jenniferhellar/CHARIoT/README.md

# CHARIoT: A Wireless, Self-Powered Sensing Node Architecture
