jenniferhellar/CHARIoT/Meeting Notes-Agendas/Fall 2018/10_12 Team Meeting.docx

Looking at the Gantt Chart

To Do:

- Comms unit test code, get power measurements
- Order sensor
- Work on measuring energy harvesting indoors/outdoors, battery charge
- Data storage needs:

Start writing unit test code

Next weekend: get together to put together the first prototype, run the test code

Test and make sure we have all the things we need to build it
