jenniferhellar/CHARIoT/Meeting Notes-Agendas/Spring 2019/4_1 Team Meeting Agenda.docx

Choose time for final presentation

Prototype #3 - solder/test today and tomorrow?

Range test

Code

- MSP-Comms completely done?
- Accelerometer
  - Jennifer (me) found the C driver for it, but it’s kinda complicated, so Idk yet
- Fuel gauge

Showcase demo

- What EXACTLY are we doing?
- Can we have it finished by Sunday i.e. cram this week and weekend?
