jenniferhellar/CHARIoT/Documentation/System Diagram Prototype #1 Dec. 2018.pdf

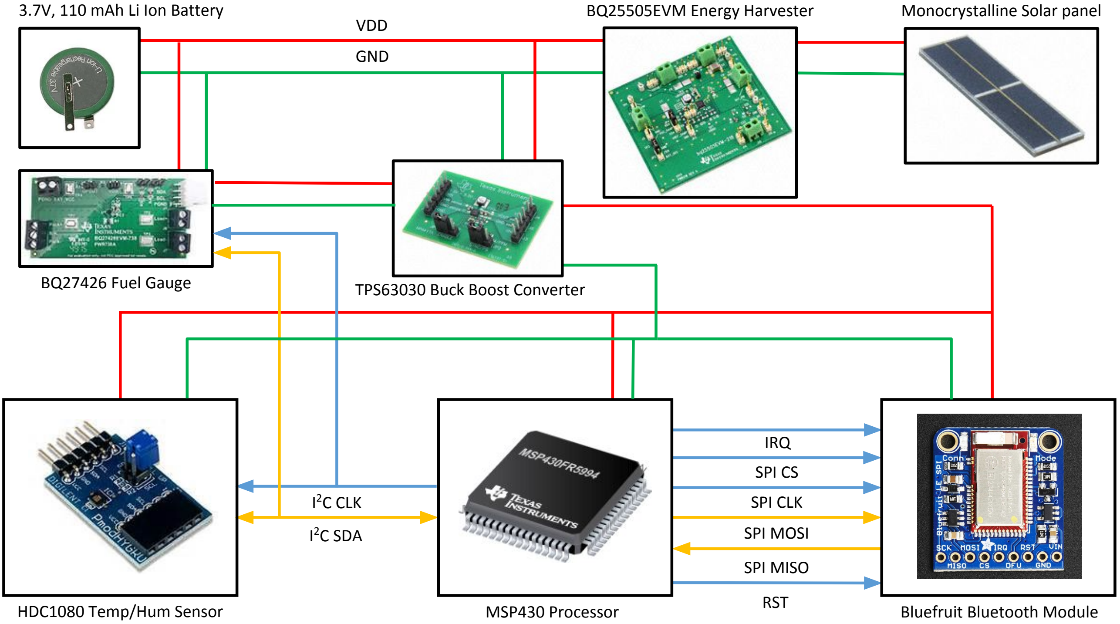
[picture p2: figure]
HDC1080 Temp/Hum Sensor; MSP430 Processor; Bluefruit Bluetooth Module; SPI MISO; SPI MOSI; SPI CLK ²C CLK; 2C SDA; VDD; GND; SPI CS; IRQ; RST

3.7V, 110 mAh Li Ion Battery | BQ25505EVM Energy Harvester | Monocrystalline Solar panel

TPS63030 Buck Boost Converter BQ27426 Fuel Gauge
