jenniferhellar/CHARIoT/Documentation/Final BOM.xlsx

Sheet: Power
Item | Designator | Min # of Units | Price/Unit | Total Price | 10000 Price/Unit | 10000 Total Price | Link
Energy Harvester | U1 | 1 | 6.236 | 6.236 | 3.915 | 3.915 | https://www.digikey.com/product-detail/en/texas-instruments/BQ25570RGRR/296-39934-1-ND/5177811
Battery | U2 | 1 | 11.09 | 11.09 | 7.033 | 7.033 | https://www.digikey.com/products/en?keywords=RJD2430C1ST1
Fuel Gauge | U3 | 1 | 2.33 | 2.33 | 1.27 | 1.27 | https://www.digikey.com/product-detail/en/texas-instruments/BQ27411DRZR-G1A/296-39935-1-ND/5177812
Solarcell | U4-U7 | 4 | $3.30 | $13.20 | 1.9536 | 7.8144 | NA
7.5MΩ | R1 | 1 | 0.12 | 0.12 | 0.02 | 0.02 | https://www.mouser.com/ProductDetail/ROHM-Semiconductor/KTR03EZPF7504
5.76MΩ | R2 | 1 | 0.04 | 0.04 | 0.004 | 0.004 | https://www.mouser.com/ProductDetail/Vishay/CRCW06035M76FKEA?qs=sGAEpiMZZMvdGkrng054t9YoKDts9whp3wjiTgYcou0%3d
374kΩ | R3 | 1 | 0.05 | 0.05 | 0.01 | 0.01 | https://www.mouser.com/ProductDetail/Yageo/RT0603FRE07374KL
6.65MΩ | R4 | 1 | 0.1 | 0.1 | 0.004 | 0.004 | https://www.mouser.com/ProductDetail/Vishay/CRCW06036M65FKEA?qs=sGAEpiMZZMvdGkrng054t9YoKDts9whp80c4NOm47Uw%3d
4.53MΩ | R5 | 1 | 0.01 | 0.01 | 0.002 | 0.002 | https://www.mouser.com/ProductDetail/Yageo/RC0603FR-074M53L
7.68MΩ | R6 | 1 | 0.04 | 0.04 | 0.002 | 0.002 | https://www.mouser.com/ProductDetail/Vishay/CRCW06037M68FKEA
4.42 MΩ | R7 | 1 | 0.01 | 0.01 | 0.002 | 0.002 | https://www.mouser.com/ProductDetail/Yageo/RC0603FR-074M42L
0.01Ω | R8 | 1 | 0.47 | 0.47 | 0.2 | 0.2 | https://www.mouser.com/ProductDetail/ROHM-Semiconductor/PMR03EZPFU10L0
DNP | R9-R10, R20 | - | - | - | - | -
0Ω | R14,R19 | - | - | - | - | -
1Ω | R15-R16 | 2 | 0.41 | 0.82 | 0.16 | 0.32 | https://www.mouser.com/ProductDetail/Yageo/SR0603FR-7T1RL
1MΩ | R17-R18 | 2 | 0.04 | 0.08 | 0.002 | 0.004 | https://www.mouser.com/ProductDetail/vishay/crcw06031m96fkea/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
22uH | L3 | 1 | 0.14 | 0.14 | 0.0632 | 0.0632 | https://www.mouser.com/ProductDetail/TDK/KLZ1608MHR220WTD25
10uH | L6 | 1 | 0.12 | 0.12 | 0.0542 | 0.0542 | https://www.mouser.com/ProductDetail/TDK/MLZ1608N100L
headers | J- | 1 | 7.95 | 7.95 | 6.36 | 6.36 | https://www.adafruit.com/product/3008
.01uF* | C1 | 1 | 0.012 | 0.012 | 0.004878 | 0.004878
0.1uF* | C2, C9 | 2 | 0.00853 | 0.01706 | 0.009756 | 0.019512
4.7uF | C3, C8 | 2 | 0.36 | 0.72 | 0.12 | 0.24 | https://www.mouser.com/ProductDetail/Murata-Electronics/GRT188C81E475KE13D
0.47uF | C4 | 1 | 0.32 | 0.32 | 0.1 | 0.1 | https://www.mouser.com/ProductDetail/KEMET/C0603C474J4RACAUTO
22uF | C5 | 1 | 0.3 | 0.3 | 0.08 | 0.08 | https://www.mouser.com/ProductDetail/Murata-Electronics/ZRB18AR61A226ME01L
100uF | C6 | 1 | 0.38 | 0.38 | 0.17 | 0.17 | https://www.mouser.com/ProductDetail/AVX/F980J107MMAAXE
1uF* | C13 | 1 | 0.0243 | 0.0243 | 0.019512 | 0.019512
 |  | Total component costs |  | 44.57936 |  | 27.711702
Final Cost Breakdown | Prototype | 10,000 unit production
Components | 44.57936 | 27.711702
Base PCB | 7.447 | 0.863465
Labor | 48.37 | 2.243188
Total | 100.39636 | 30.818355

Sheet: Comms
Item | designator | Min # of Units | Price/Unit | Total Price | 10000 Price/Unit | 10000Total Price | Link
32KHz crystal oscillator* | 32K | 1 | 0.46 | 0.46 | 0.2134147671 | 0.2134147671
48MHz crystal oscillator* | 48M | 1 | 0.86 | 0.86 | 0.48 | 0.48
12pF | C2,C5-C6,C101 | 4 | 0.0286 | 0.1144 | 0.01663 | 0.06652 | https://www.digikey.com/product-detail/en/CC0603JRNPO9BN120/311-1059-1-ND/302969?so=58739282
1.8pF | C102 | 1 | 0.061 | 0.061 | 0.0153 | 0.0153 | https://www.digikey.com/product-detail/en/yageo/CC0603CRNPO9BN1R8/311-3852-1-ND/8024941
22uF | C10,C14 | 2 | 0.3 | 0.6 | 0.08 | 0.16 | https://www.mouser.com/ProductDetail/Murata-Electronics/ZRB18AR61A226ME01L
0.1uF* | C8-C9,C11-C13,C15-C16 | 7 | 0.00853 | 0.05971 | 0.004878 | 0.034146
1pF | C1,C3,C7 | 3 | 0.061 | 0.183 | 0.0153 | 0.0459 | https://www.digikey.com/product-detail/en/yageo/CC0603CRNPO9BN1R8/311-3852-1-ND/8024941
1uF* | C4,CIN | 2 | 0.0243 | 0.0486 | 0.019512 | 0.039024
1nF* | CT | 1 | 0.0109 | 0.0109 | 0.006098 | 0.006098
schottky diode* | D1 | 1 | 0.1097 | 0.1097 | 0.071951 | 0.071951
ferrite beads* | Filter | 1 | 0.16 | 0.16 | 0.0650367814 | 0.0650367814 | https://www.digikey.com/product-detail/en/murata-electronics-north-america/BLM18HE152SN1D/490-5216-1-ND/1948392
headers | J1-J6 | 4 | 0.59 | 2.36 |  | 0
2.4nH | L1,L4 | 2 | 0.21 | 0.42 | 0.09782 | 0.19564 | https://www.digikey.com/product-detail/en/murata-electronics-north-america/LQW18AN2N4C80D/490-14721-1-ND/6606327
2nH | L2-L3 | 2 | 0.244 | 0.488 | 0.1097 | 0.2194 | https://www.digikey.com/product-detail/en/johanson-technology-inc/L-14W2N0CV4E/712-1618-1-ND/6612954
8.6uH | L6 | 1 | 0.471 | 0.471 | 0.22874 | 0.22874 | https://www.digikey.com/product-detail/en/abracon-llc/AISC-0603F-8R2J-T/535-12536-1-ND/4864679
green led* | LED1 | 1 | 0.219 | 0.219 | 0.060976 | 0.060976
100kΩ* | R1 | 1 | 0.0097 | 0.0097 | 0.003659 | 0.003659
100Ω* | R4 | 1 | 0.0097 | 0.0097 | 0.003659 | 0.003659
500 | REXT | 1 | 2.812 | 2.812 | 1.28 | 1.28 | https://www.digikey.com/product-detail/en/vishay-dale/TNPU0603500RAZEN00/541-3301-1-ND/6615958
DNP | R_BP | 0 |  | 0 |  | 0
47kΩ | R_PD | 1 | 0.02 | 0.02 | 0.00395 | 0.00395 | https://www.digikey.com/product-detail/en/yageo/RC0603JR-0747KL/311-47KGRCT-ND/729741
DNP | R_SMA | 0 |  | 0 |  | 0
DNP | SMA | 0 |  | 0 |  | 0
load switch | TPS22918 | 1 | 0.38 | 0.38 | 0.20365816 | 0.20365816 | http://www.ti.com/product/TPS22918/technicaldocuments?HQS=TI-null-null-octopart-df-pf-null-wwe
mcu | U1 | 1 | 5.29 | 5.29 | 3 | 3 | http://www.ti.com/product/CC2652R
 |  | Total Components Cost |  | 15.14671 |  | 6.397072708
Final Cost Breakdown | Prototype | 10,000 unit production
Components | 15.14671 | 6.397072708
Base PCB | 8.954 | 1.07929
Labor | 61.178 | 2.273723
Total | 85.27871 | 9.750085708

Sheet: Processor
Item | Designator | Min # of Units | Price/Unit | Total Price | 10000 Price/Unit | 10000Total Price | Link
Accelerometer | ACCEL | 1 | $1.61 | $1.61 | 0.63 | 0.63 | https://www.mouser.com/ProductDetail/Bosch-Sensortec/BMA253?qs=z6PAvqrnkvQsf%2FKkNyclQA%3D%3D
0.1uF* | C0-C1,C3,C5,C7,C9,C11,C15 | 8 | 0.00853 | 0.06824 | 0.004878 | 0.039024
1uF* | C2,C4,C6,C8,C10,C12 | 6 | 0.0243 | 0.1458 | 0.01951216667 | 0.117073
1nF* | C13 | 1 | 0.0109 | 0.0109 | 0.006098 | 0.006098
22uF | C14 | 1 | 0.3 | 0.3 | 0.08 | 0.08 | https://www.mouser.com/ProductDetail/Murata-Electronics/ZRB18AR61A226ME01L
Schottky diode* | D1 | 1 | 0.1097 | 0.1097 | 0.071951 | 0.071951
headers | J1-5 | 1 | - | - | - | -
headers | JTAG | 1 | - | - | - | -
green led* | LED1 | 1 | 0.219 | 0.219 | 0.060976 | 0.060976
red led* | LED2 | 1 | 0.219 | 0.219 | 0.060976 | 0.060976
msp430fr59941pnr | MSP430 | 1 | $6.91 | $6.91 | 4.18 | 4.18 | https://www.mouser.com/ProductDetail/Texas-Instruments/MSP430FR5994IPNR
2kΩ* | R1-R2 | 2 | 0.00975 | 0.0195 | 0.0036585 | 0.007317
4.7kΩ* | R3 | 1 | 0.00975 | 0.00975 | 0.003659 | 0.003659
100Ω | R4-R5 | 2 | 0.00975 | 0.0195 | 0.0036585 | 0.007317
2kΩ* | R8-R9 | 2 | 0.00975 | 0.0195 | 0.0036585 | 0.007317
temperature & humidity sensor | TEMP_SENSOR | 1 | $2.51 | $2.51 | 1.27 | 1.27 | https://www.mouser.com/ProductDetail/Texas-Instruments/HDC1080DMBR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
 |  | Total component costs |  | $12.17 |  | 6.541708
Final Cost Breakdown | Prototype | 10,000 unit production
Components | $12.17 | 6.541708
Base PCB | 7.447 | 0.863465
Labor | 51.252 | 2.253366
Total | $70.87 | 9.658539

Sheet: Part Numbers
Part Name | Part Designator | Part Number
Energy harvesting | U1 | BQ25570RGRR
Battery | U1 | RJD2430C1ST1
Fuel gauge | U3 | BQ27411DRZR-G1A
Solarcell | U4-U7 | KXOB22-04X3F
Processor | MSP430 | MSP430FR9941PNR
Temperature & Humidity Sensor | TEMP_SENSOR | HDC1080DMBR
Accelerometer | ACCEL | BMA253
32KHz crystal oscillator | 32K | FC-135 32.7680KA-A3
48MHz crystal oscillator | 48M | NX2016SA-48M-EXS00A-CS05517
schottky diode | D1 | MF-DIO-SOD123-BAT42
ferrite beads | Filter | BLM18HE152SN1D
load switch | TPS22918 | TPS22918
MCU | U1 | CC2652R
