jenniferhellar/CHARIoT/(list of files, cad)

Other CAD files:
Code/TICommsWorkspace/ble5_project_zero_cc26x2r1lp_app/TOOLS/src/sysbios/m3_Hwi_asm_switch.obj
Code/TICommsWorkspace/ble5_simple_peripheral_cc26x2r1lp_app/TOOLS/src/sysbios/m3_IntrinsicsSupport_asm.obj
Code/TICommsWorkspaceRevE/simple_central_app_CC26X2R1_LAUNCHXL_tirtos_ccs/src/sysbios/m3_IntrinsicsSupport_asm.obj
Code/TICommsWorkspace/ble5_project_zero_cc26x2r1lp_app/TOOLS/src/sysbios/m3_Hwi_asm.obj
Code/TICommsWorkspace/ble5_simple_central_cc26x2r1lp_app/TOOLS/src/sysbios/m3_Hwi_asm.obj
Code/TICommsWorkspaceRevE/simple_central_app_CC26X2R1_LAUNCHXL_tirtos_ccs/src/sysbios/m3_Hwi_asm_switch.obj
Code/TICommsWorkspace/ble5_project_zero_cc26x2r1lp_app/TOOLS/src/sysbios/m3_TaskSupport_asm.obj
Code/TICommsWorkspace/ble5_simple_central_cc26x2r1lp_app/TOOLS/src/sysbios/m3_IntrinsicsSupport_asm.obj
Code/TICommsWorkspace/ble5_simple_peripheral_cc26x2r1lp_app/TOOLS/src/sysbios/m3_Hwi_asm_switch.obj
Code/TICommsWorkspace/ble5_simple_central_cc26x2r1lp_app/TOOLS/src/sysbios/m3_TaskSupport_asm.obj
Code/TICommsWorkspace/ble5_simple_peripheral_cc26x2r1lp_app/TOOLS/src/sysbios/m3_TaskSupport_asm.obj
Code/TICommsWorkspaceRevE/simple_central_app_CC26X2R1_LAUNCHXL_tirtos_ccs/src/sysbios/m3_Hwi_asm.obj
Code/TICommsWorkspace/ble5_project_zero_cc26x2r1lp_app/TOOLS/src/sysbios/m3_IntrinsicsSupport_asm.obj
Code/TICommsWorkspace/ble5_simple_central_cc26x2r1lp_app/TOOLS/src/sysbios/m3_Hwi_asm_switch.obj
Code/TICommsWorkspace/ble5_simple_peripheral_cc26x2r1lp_app/TOOLS/src/sysbios/m3_Hwi_asm.obj
Code/TICommsWorkspaceRevE/simple_central_app_CC26X2R1_LAUNCHXL_tirtos_ccs/src/sysbios/m3_TaskSupport_asm.obj
Code/TICommsWorkspace/ble5_simple_central_cc26x2r1lp_app/TOOLS/src/sysbios/BIOS.obj
Code/TICommsWorkspace/ble5_simple_peripheral_cc26x2r1lp_app/TOOLS/src/sysbios/rom_sysbios.obj
Code/TICommsWorkspaceRevE/simple_central_app_CC26X2R1_LAUNCHXL_tirtos_ccs/src/sysbios/rom_sysbios.obj
Code/TICommsWorkspace/ble5_project_zero_cc26x2r1lp_app/TOOLS/src/sysbios/BIOS.obj
Code/TICommsWorkspace/ble5_simple_central_cc26x2r1lp_app/TOOLS/src/sysbios/rom_sysbios.obj
