jenniferhellar/CHARIoT/Boards/Prototype #2 (PCB Ver. A1)/CHARIoT_Power/chariot_power.brd

## EAGLE design Boards/Prototype #2 (PCB Ver. A1)/CHARIoT_Power/chariot_power.brd (2020-01-18)

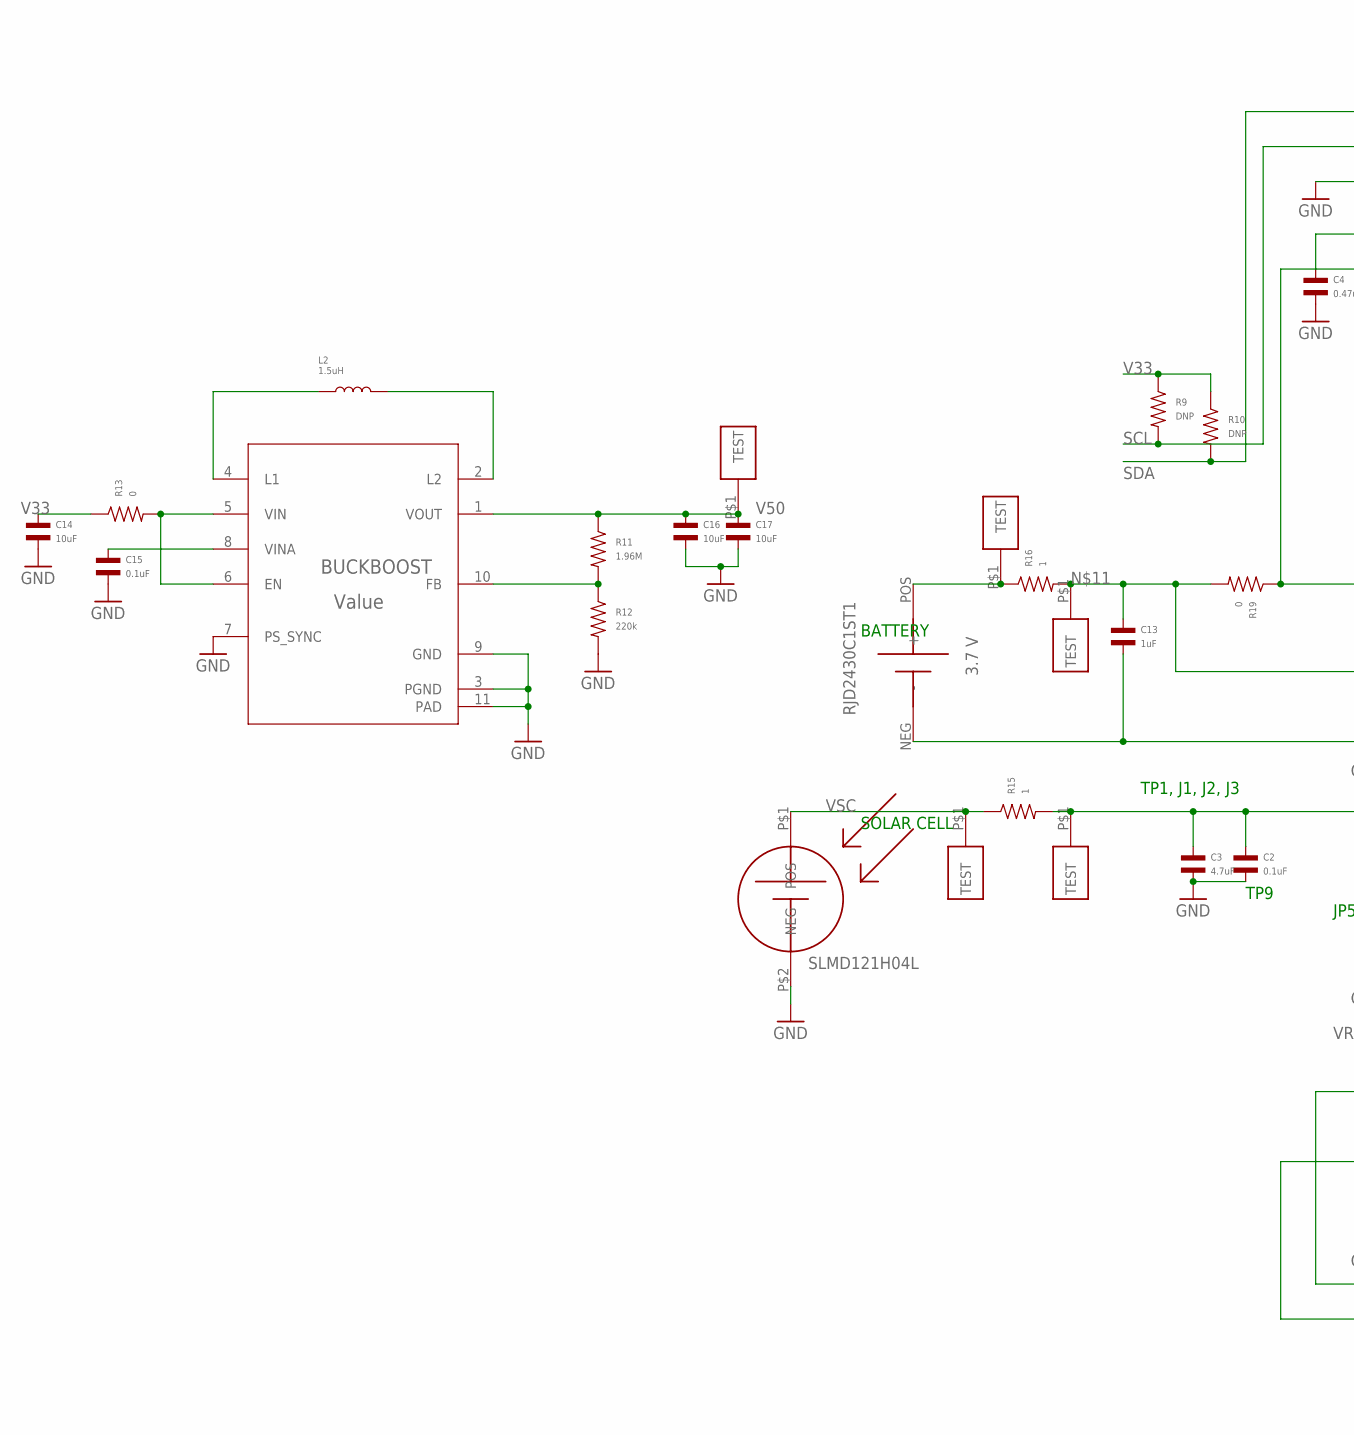
[picture p13: schematic chariot_power.sch, part in row 1, column 1]

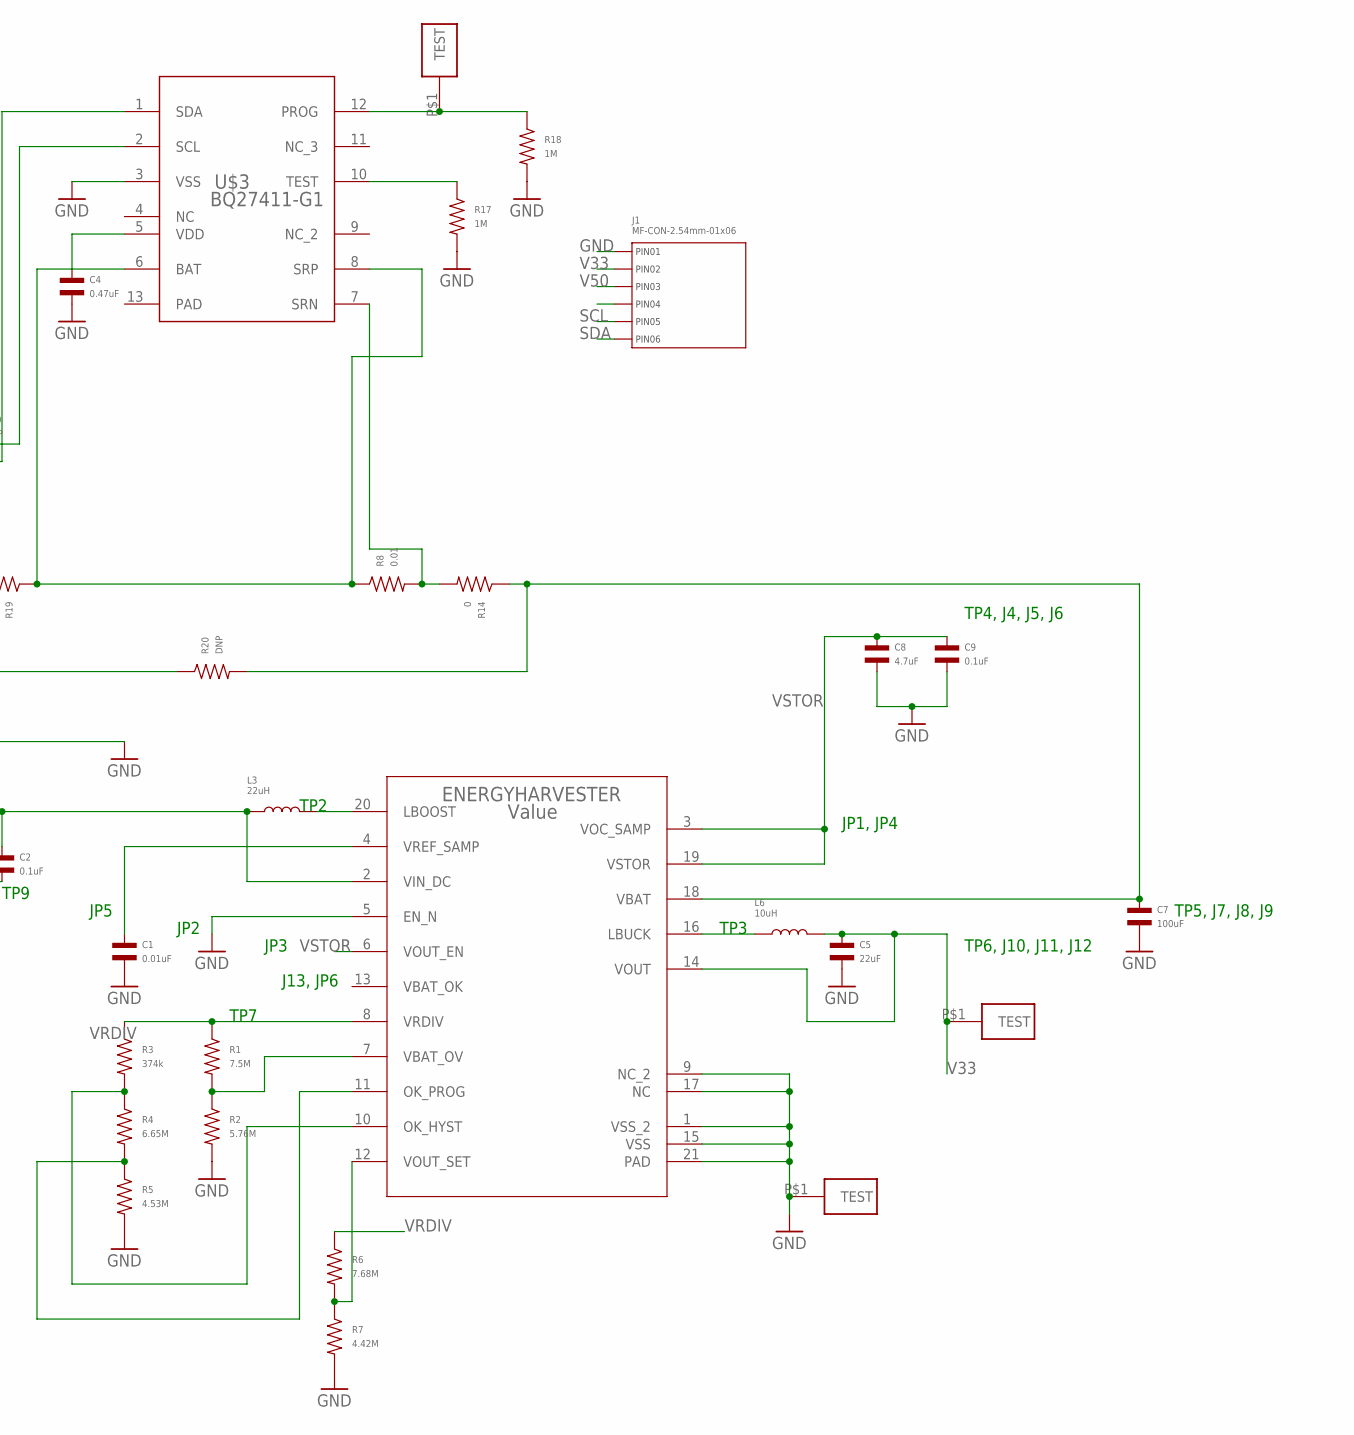
[picture p14: schematic chariot_power.sch, part in row 1, column 2]

Parts:
BUCKBOOST: Value; DSK0010A
C1: 0.01uF; C0603
C2, C9, C15: 0.1uF; C0603
C3, C8: 4.7uF; C0603
C4: 0.47uF; C0603
C5: 22uF; C0603
C7: 100uF; C0603
C13: 1uF; C0603
C14, C16, C17: 10uF; C0603
ENERGYHARVESTER: Value; RGR0020A
J1: MF-CON-2.54mm-01x06; PTH_2.54MM_01X06
L2: 1.5uH; L0603
L3: 22uH; L0603
L6: 10uH; L0603
R1: 7.5M; R0603
R2: 5.76M; R0603
R3: 374k; R0603
R4: 6.65M; R0603
R5: 4.53M; R0603
R6: 7.68M; R0603
R7: 4.42M; R0603
R8: 0.01; R0603
R9, R10, R20: DNP; R0603
R11: 1.96M; R0603
R12: 220k; R0603
R13, R14, R19: 0; R0603
R15, R16: 1; R0603
R17, R18: 1M; R0603
TP1, TP2, TP3, TP4, TP5, TP6, TP7, TP8: TESTPOINT_LOOP
U$1: SLMD121H04L
U$2: RJD2430C1ST1.; RJD2430C1ST1
U$3: BQ27411-G1; DRZ0012A

Connections:
EXT_VCC: J1.P$4 (PIN4)
GND: BUCKBOOST.3 (PGND), BUCKBOOST.7 (PS_SYNC), BUCKBOOST.9 (GND), BUCKBOOST.11 (PAD), C1.P$2, C2.P$2, C3.P$2, C4.P$2, C5.P$2, C7.P$2, C8.P$2, C9.P$2, C13.P$2, C14.P$2, C15.P$2, C16.P$2, C17.P$2, ENERGYHARVESTER.1 (VSS_2), ENERGYHARVESTER.5 (EN_N), ENERGYHARVESTER.9 (NC_2), ENERGYHARVESTER.15 (VSS), ENERGYHARVESTER.17 (NC), ENERGYHARVESTER.21 (PAD), J1.P$1 (PIN1), R2.P$2, R5.P$2, R7.P$2, R12.P$2, R17.P$2, R18.P$2, TP1.P$1, U$1.P$2 (NEG), U$2.NEG (-), U$3.3 (VSS)
unnamed: C1.P$1, ENERGYHARVESTER.4 (VREF_SAMP)
unnamed: ENERGYHARVESTER.20 (LBOOST), L3.P$2
unnamed: C7.P$1, ENERGYHARVESTER.18 (VBAT), R14.P$1, R20.P$2
unnamed: ENERGYHARVESTER.16 (LBUCK), L6.P$1
unnamed: C14.P$1, R13.P$1
unnamed: ENERGYHARVESTER.7 (VBAT_OV), R1.P$2, R2.P$1
unnamed: ENERGYHARVESTER.12 (VOUT_SET), R6.P$2, R7.P$1
unnamed: R17.P$1, U$3.10 (TEST)
unnamed: ENERGYHARVESTER.10 (OK_HYST), R3.P$2, R4.P$1
unnamed: ENERGYHARVESTER.11 (OK_PROG), R4.P$2, R5.P$1
unnamed: C13.P$1, R16.P$2, R19.P$2, R20.P$1, TP7.P$1
unnamed: BUCKBOOST.4 (L1), L2.P$1
unnamed: R8.P$2, R14.P$2, U$3.7 (SRN)
unnamed: R18.P$1, TP8.P$1, U$3.12 (PROG)
unnamed: C4.P$1, U$3.5 (VDD)
unnamed: BUCKBOOST.2 (L2), L2.P$2
unnamed: BUCKBOOST.8 (VINA), C15.P$1
unnamed: BUCKBOOST.10 (FB), R11.P$2, R12.P$1
SCL: J1.P$5 (PIN5), R9.P$2, U$3.2 (SCL)
SDA: J1.P$6 (PIN6), R10.P$2, U$3.1 (SDA)
V33: BUCKBOOST.5 (VIN), BUCKBOOST.6 (EN), C5.P$1, ENERGYHARVESTER.14 (VOUT), J1.P$2 (PIN2), L6.P$2, R9.P$1, R10.P$1, R13.P$2, TP2.P$1
V50: BUCKBOOST.1 (VOUT), C16.P$1, C17.P$1, J1.P$3 (PIN3), R11.P$1, TP3.P$1
VBAT: R16.P$1, TP5.P$1, U$2.POS (+)
VBAT2: R8.P$1, R19.P$1, U$3.6 (BAT), U$3.8 (SRP)
VIN1: C2.P$1, C3.P$1, ENERGYHARVESTER.2 (VIN_DC), L3.P$1, R15.P$2, TP6.P$1
VRDIV: ENERGYHARVESTER.8 (VRDIV), R1.P$1, R3.P$1, R6.P$1
VSC: R15.P$1, TP4.P$1, U$1.P$1 (POS)
VSTOR: C8.P$1, C9.P$1, ENERGYHARVESTER.3 (VOC_SAMP), ENERGYHARVESTER.6 (VOUT_EN), ENERGYHARVESTER.19 (VSTOR)

Notes on the sheet:
TP2
JP5
JP2
TP9
TP3
TP6, J10, J11, J12
TP1, J1, J2, J3
J13, JP6
TP5, J7, J8, J9
JP3
TP7
JP1, JP4
TP4, J4, J5, J6
SOLAR CELL
BATTERY

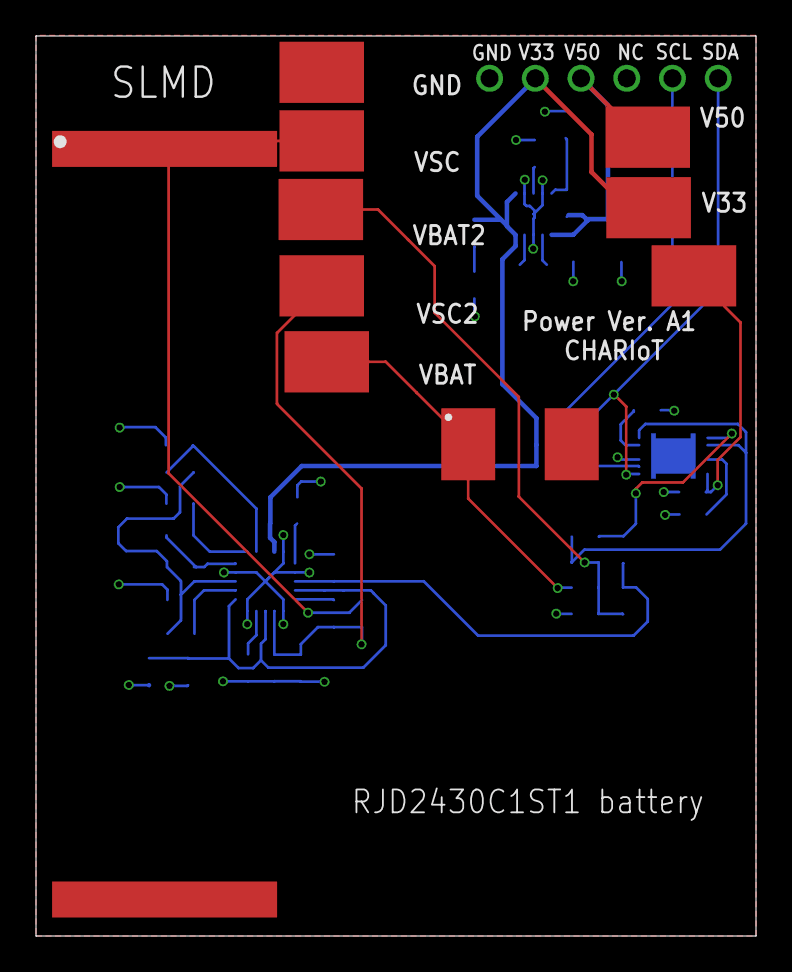
[picture p15: board chariot_power.brd from above]

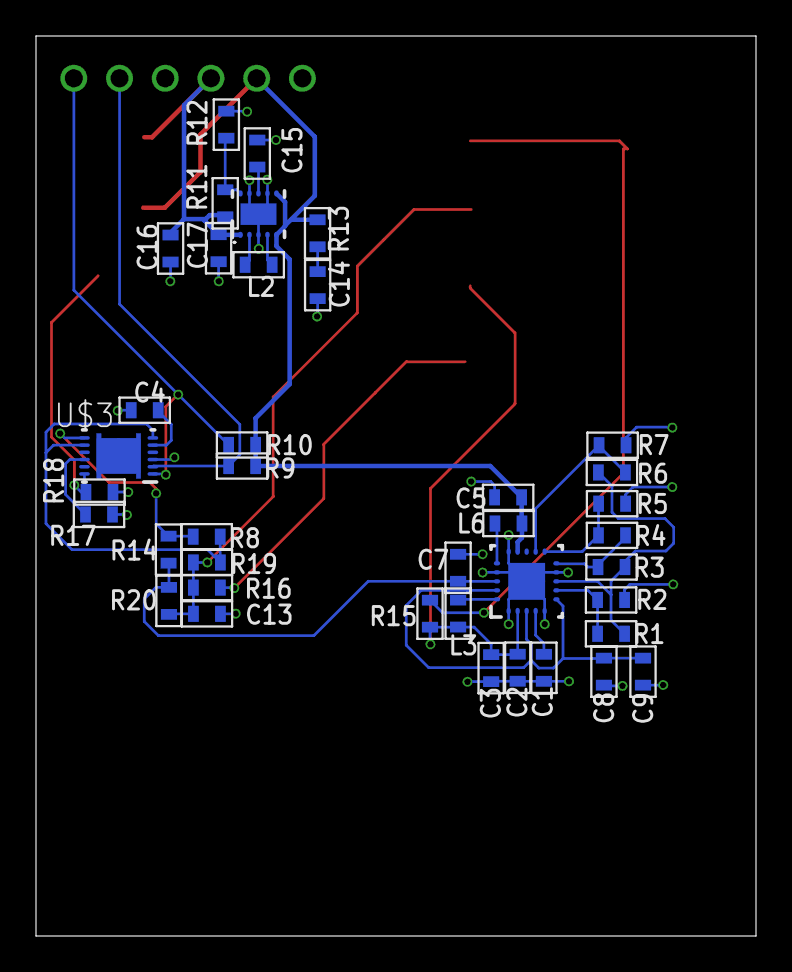
[picture p16: board chariot_power.brd from below]

Board: 2 copper layers, 40.0 x 50.0 mm, 50 parts (39 on the bottom side), 29 nets.
