jenniferhellar/CHARIoT/Boards/Prototype #2 (PCB Ver. A1)/CHARIoT_CommsA/chariot_comms_a.brd

## EAGLE design Boards/Prototype #2 (PCB Ver. A1)/CHARIoT_CommsA/chariot_comms_a.brd (2020-01-18)

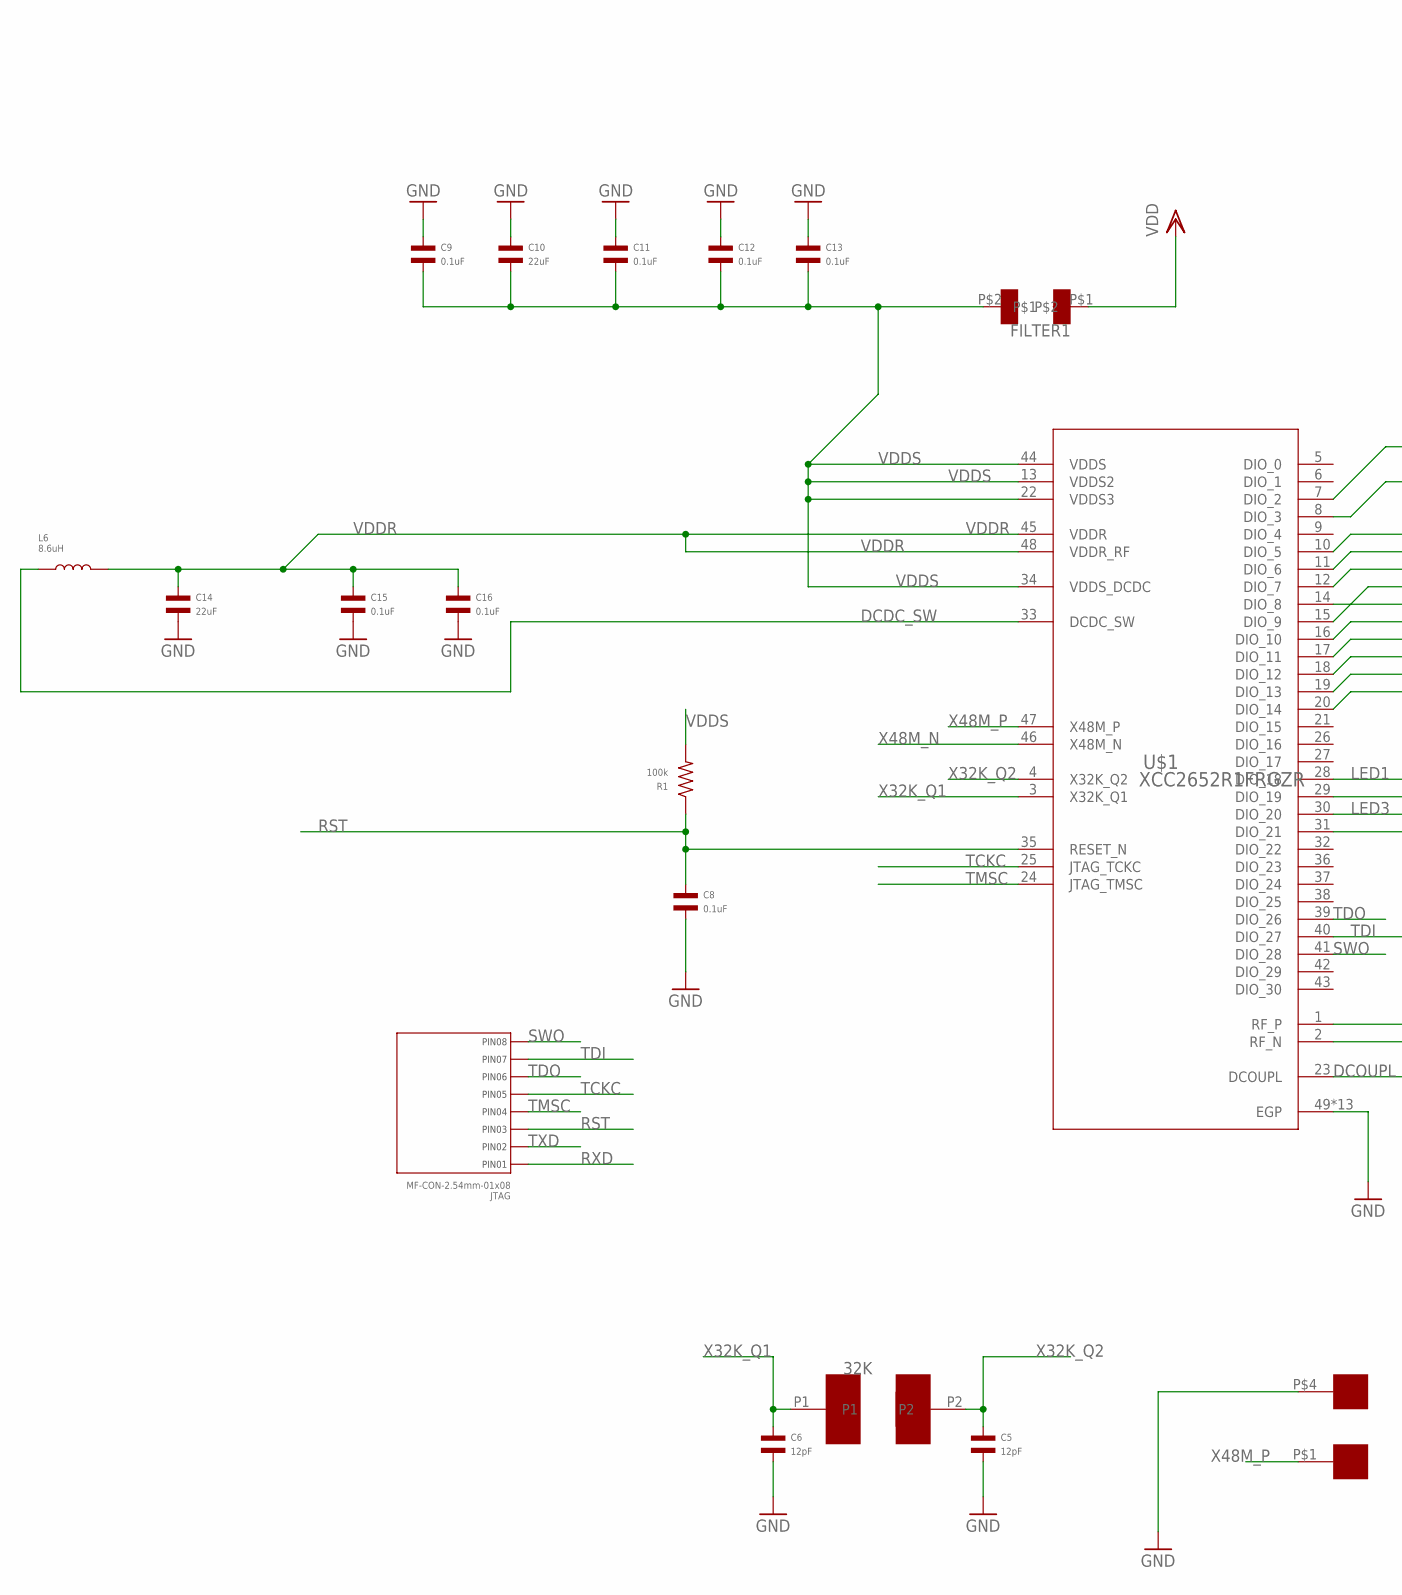
[picture p17: schematic chariot_comms_a.sch, part in row 1, column 1]

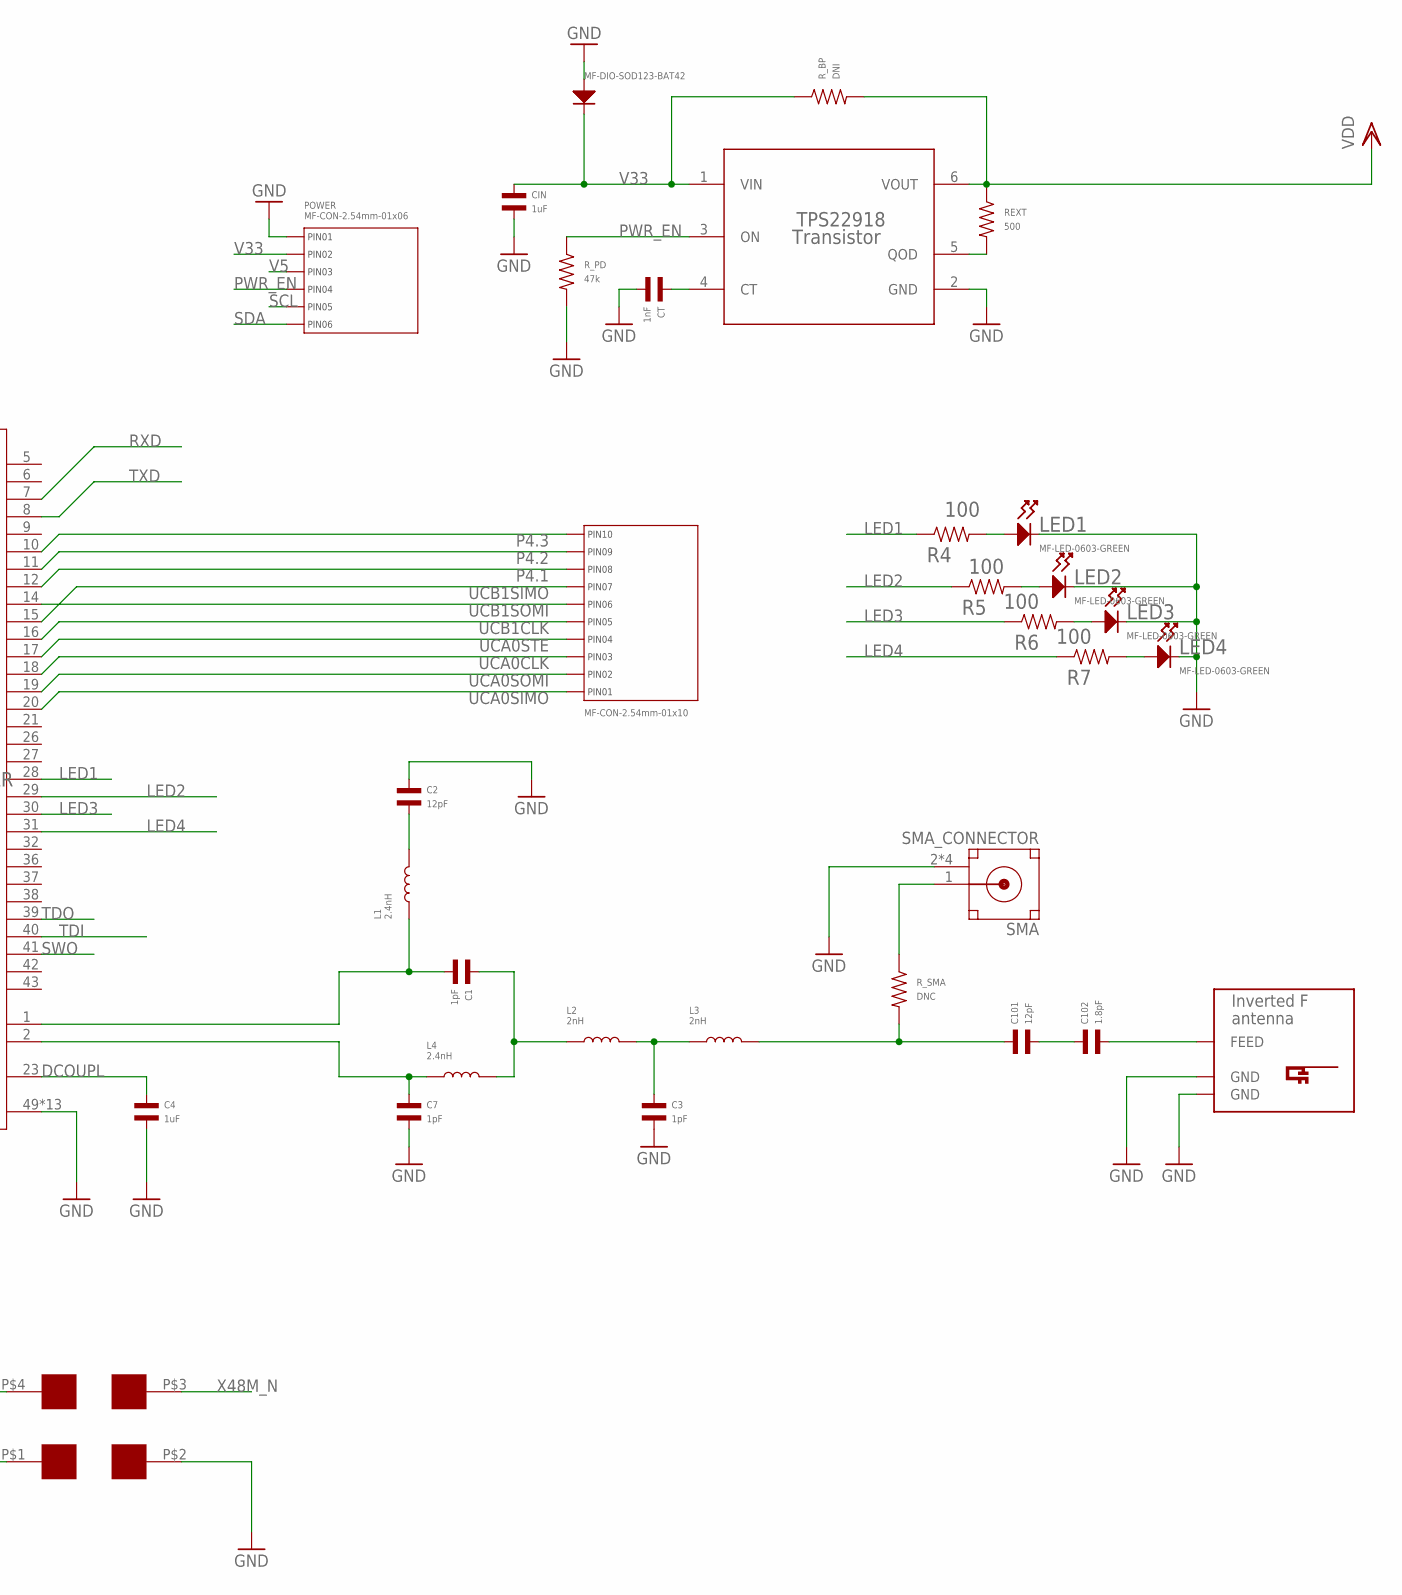
[picture p18: schematic chariot_comms_a.sch, part in row 1, column 2]

Parts:
32K: FC-135
48M: NX2016SA-48M-EXS00A-CS05517
C1, C3, C7: 1pF; C0603
C2, C5, C6, C101: 12pF; C0603
C4: 1uF; C0603
C8, C9, C11, C12, C13, C15, C16: 0.1uF; C0603
C10, C14: 22uF; C0603
C102: 1.8pF; C0603
CIN: 1uF; C0603
COMMS_J: MF-CON-2.54mm-01x10; PTH_2.54MM_01X10
CT: 1nF; C0603
D1: MF-DIO-SOD123-BAT42; SOD-123
FILTER1: BLM18HE152SN1D
JTAG: MF-CON-2.54mm-01x08; PTH_2.54MM_01X08
L1, L4: 2.4nH; L0603
L2, L3: 2nH; L0603
L6: 8.6uH; L0603
LED1, LED2, LED3, LED4: MF-LED-0603-GREEN; LED0603
POWER: MF-CON-2.54mm-01x06; PTH_2.54MM_01X06
R1: 100k; R0603
R4, R5, R6, R7: 100; R0603
REXT: 500; R0603
R_BP: DNI; R0603
R_PD: 47k; R0603
R_SMA: DNC; R0603
SMA: SMA_CONNECTOR; LPRS_SMA_CONNECTOR
TPS22918: Transistor; DBV0006A_N
U$1: XCC2652R1FRGZR; RGZ0048A
U$2: INVERTED_F_ANTENNA+5; DN007+5

Connections:
DCDC_SW: L6.P$1, U$1.33 (DCDC_SW)
DCOUPL: C4.P$1, U$1.23 (DCOUPL)
GND: 48M.P$2, 48M.P$4, C2.P$1, C3.P$2, C4.P$2, C5.P$2, C6.P$2, C7.P$2, C8.P$2, C9.P$1, C10.P$1, C11.P$1, C12.P$1, C13.P$1, C14.P$2, C15.P$2, C16.P$2, CIN.P$2, CT.P$2, D1.ANODE, LED1.CATHODE, LED2.CATHODE, LED3.CATHODE, LED4.CATHODE, POWER.P$1 (PIN1), R_PD.P$2, SMA.2 (GND), SMA.3 (GND), SMA.4 (GND), SMA.5 (GND), TPS22918.2 (GND), U$1.49 (EGP), U$1.V1 (EGP), U$1.V2 (EGP), U$1.V3 (EGP), U$1.V4 (EGP), U$1.V5 (EGP), U$1.V6 (EGP), U$1.V7 (EGP), U$1.V8 (EGP), U$1.V9 (EGP), U$1.V10 (EGP), U$1.V11 (EGP), U$1.V12 (EGP), U$2.GND, U$2.GND@1 (GND)
LED1: R4.P$1, U$1.28 (DIO_18)
LED2: R5.P$1, U$1.29 (DIO_19)
LED3: R6.P$1, U$1.30 (DIO_20)
LED4: R7.P$1, U$1.31 (DIO_21)
unnamed: C102.P$2, U$2.FEED
unnamed: LED1.ANODE, R4.P$2
unnamed: C2.P$2, L1.P$2
unnamed: C1.P$1, L2.P$1, L4.P$2
unnamed: C3.P$1, L2.P$2, L3.P$1
unnamed: C101.P$1, L3.P$2, R_SMA.P$2
unnamed: C101.P$2, C102.P$1
unnamed: LED2.ANODE, R5.P$2
unnamed: REXT.P$2, TPS22918.5 (QOD)
unnamed: CT.P$1, TPS22918.4 (CT)
unnamed: LED3.ANODE, R6.P$2
unnamed: LED4.ANODE, R7.P$2
unnamed: R_SMA.P$1, SMA.1 (SIG)
P4.1: COMMS_J.P$8 (PIN8), U$1.12 (DIO_7)
P4.2: COMMS_J.P$9 (PIN9), U$1.11 (DIO_6)
P4.3: COMMS_J.P$10 (PIN10), U$1.10 (DIO_5)
PWR_EN: POWER.P$4 (PIN4), R_PD.P$1, TPS22918.3 (ON)
RF_N: C7.P$1, L4.P$1, U$1.2 (RF_N)
RF_P: C1.P$2, L1.P$1, U$1.1 (RF_P)
RST: C8.P$1, JTAG.P$3 (PIN3), R1.P$1, U$1.35 (RESET_N)
RXD: JTAG.P$1 (PIN1), U$1.7 (DIO_2)
SCL: POWER.P$5 (PIN5)
SDA: POWER.P$6 (PIN6)
SWO: JTAG.P$8 (PIN8), U$1.41 (DIO_28)
TCKC: JTAG.P$5 (PIN5), U$1.25 (JTAG_TCKC)
TDI: JTAG.P$7 (PIN7), U$1.40 (DIO_27)
TDO: JTAG.P$6 (PIN6), U$1.39 (DIO_26)
TMSC: JTAG.P$4 (PIN4), U$1.24 (JTAG_TMSC)
TXD: JTAG.P$2 (PIN2), U$1.8 (DIO_3)
UCA0CLK: COMMS_J.P$3 (PIN3), U$1.18 (DIO_12)
UCA0SIMO: COMMS_J.P$1 (PIN1), U$1.20 (DIO_14)
UCA0SOMI: COMMS_J.P$2 (PIN2), U$1.19 (DIO_13)
UCA0STE: COMMS_J.P$4 (PIN4), U$1.17 (DIO_11)
UCB1CLK: COMMS_J.P$5 (PIN5), U$1.16 (DIO_10)
UCB1SIMO: COMMS_J.P$7 (PIN7), U$1.15 (DIO_9)
UCB1SOMI: COMMS_J.P$6 (PIN6), U$1.14 (DIO_8)
V5: POWER.P$3 (PIN3)
V33: CIN.P$1, D1.CATHODE, POWER.P$2 (PIN2), R_BP.P$1, TPS22918.1 (VIN)
VDD: FILTER1.P$1, REXT.P$1, R_BP.P$2, TPS22918.6 (VOUT)
VDDR: C14.P$1, C15.P$1, C16.P$1, L6.P$2, U$1.45 (VDDR), U$1.48 (VDDR_RF)
VDDS: C9.P$2, C10.P$2, C11.P$2, C12.P$2, C13.P$2, FILTER1.P$2, R1.P$2, U$1.13 (VDDS2), U$1.22 (VDDS3), U$1.34 (VDDS_DCDC), U$1.44 (VDDS)
X32K_Q1: 32K.P1, C6.P$1, U$1.3 (X32K_Q1)
X32K_Q2: 32K.P2, C5.P$1, U$1.4 (X32K_Q2)
X48M_N: 48M.P$3, U$1.46 (X48M_N)
X48M_P: 48M.P$1, U$1.47 (X48M_P)

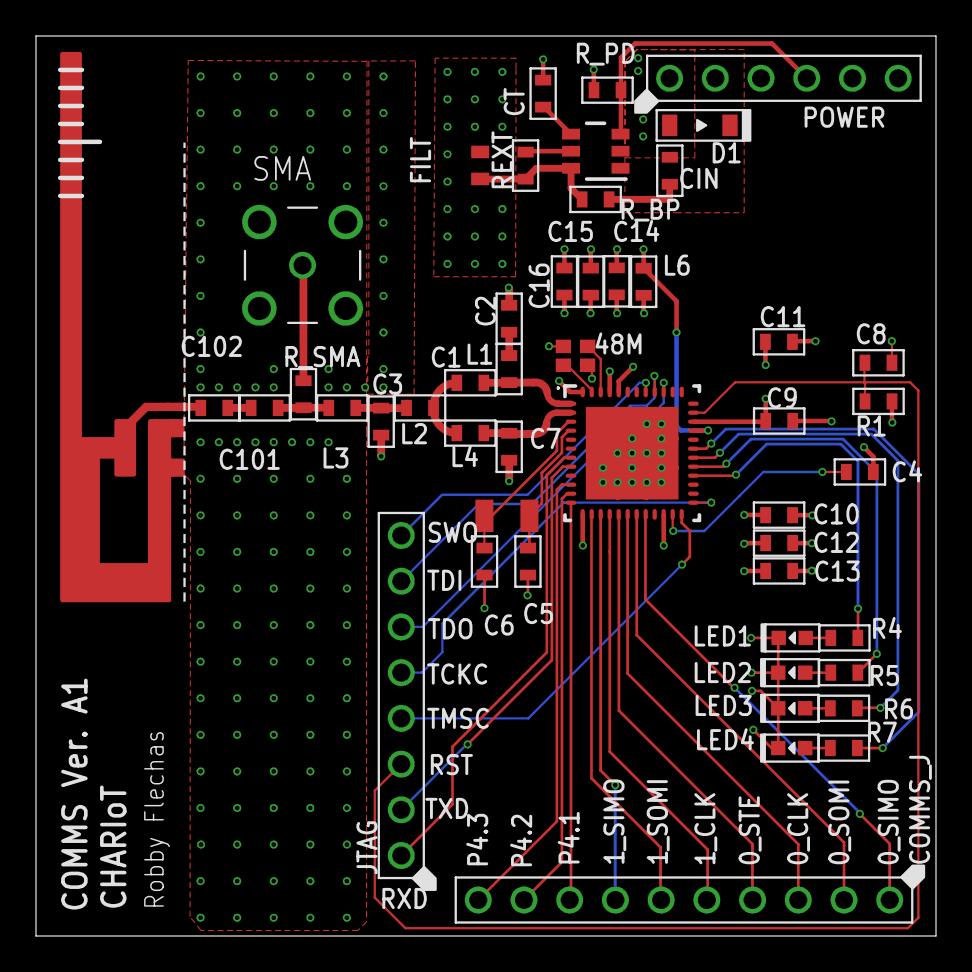
[picture p19: board chariot_comms_a.brd from above]

Board: 4 copper layers, 50.0 x 50.0 mm, 49 parts (0 on the bottom side), 49 nets.
