jenniferhellar/CHARIoT/Boards/Prototype #2 (PCB Ver. A1)/CHARIoT_Sensor/chariot_sensor.brd

## EAGLE design Boards/Prototype #2 (PCB Ver. A1)/CHARIoT_Sensor/chariot_sensor.brd (2020-01-18)

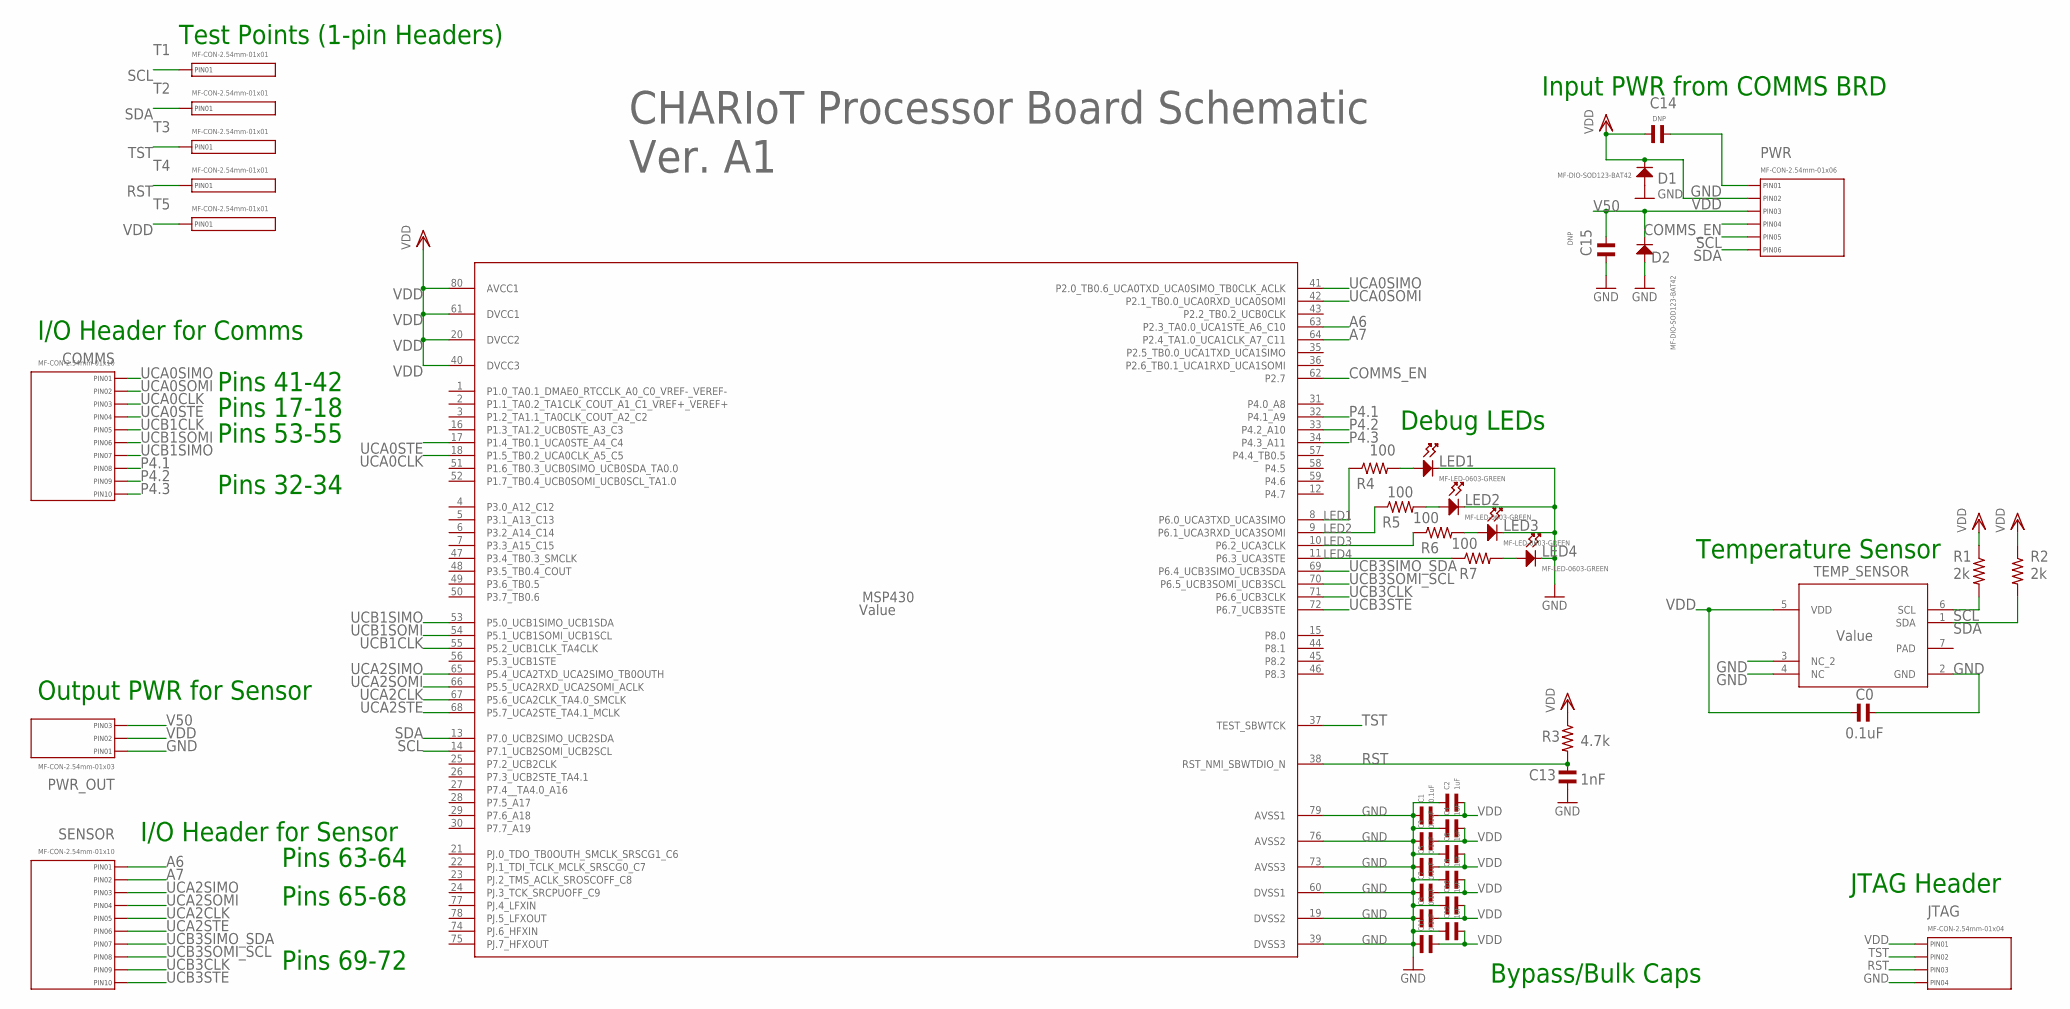
[picture p20: schematic chariot_sensor.sch]

Parts:
C0, C1, C3, C5, C7, C9, C11: 0.1uF; C0603
C2, C4, C6, C8, C10, C12: 1uF; C0603
C13: 1nF; C0603
C14, C15: DNP; C0603
COMMS: MF-CON-2.54mm-01x10; PTH_2.54MM_01X10
D1, D2: MF-DIO-SOD123-BAT42; SOD-123
JTAG: MF-CON-2.54mm-01x04; PTH_2.54MM_01X04
LED1, LED2, LED3, LED4: MF-LED-0603-GREEN; LED0603
MSP430: Value; PN0080A_N
PWR: MF-CON-2.54mm-01x06; PTH_2.54MM_01X06
PWR_OUT: MF-CON-2.54mm-01x03; PTH_2.54MM_01X03
R1, R2: 2k; R0603
R3: 4.7k; R0603
R4, R5, R6, R7: 100; R0603
SENSOR: MF-CON-2.54mm-01x10; PTH_2.54MM_01X10
T1, T2, T3, T4, T5: MF-CON-2.54mm-01x01; PTH_2.54MM_01X01
TEMP_SENSOR: Value; DMB0006A

Connections:
A6: MSP430.63 (P2.3_TA0.0_UCA1STE_A6_C10), SENSOR.P$1 (PIN1)
A7: MSP430.64 (P2.4_TA1.0_UCA1CLK_A7_C11), SENSOR.P$2 (PIN2)
COMMS_EN: MSP430.62 (P2.7), PWR.P$4 (PIN4)
GND: C0.P$2, C1.P$1, C2.P$1, C3.P$1, C4.P$1, C5.P$1, C6.P$1, C7.P$1, C8.P$1, C9.P$1, C10.P$1, C11.P$1, C12.P$1, C13.P$2, C14.P$2, C15.P$2, D1.ANODE, D2.ANODE, JTAG.P$4 (PIN4), LED1.CATHODE, LED2.CATHODE, LED3.CATHODE, LED4.CATHODE, MSP430.19 (DVSS2), MSP430.39 (DVSS3), MSP430.60 (DVSS1), MSP430.73 (AVSS3), MSP430.76 (AVSS2), MSP430.79 (AVSS1), PWR.P$1 (PIN1), PWR_OUT.P$1 (PIN1), TEMP_SENSOR.2 (GND), TEMP_SENSOR.3 (NC_2), TEMP_SENSOR.4 (NC)
LED1: MSP430.8 (P6.0_UCA3TXD_UCA3SIMO), R4.P$1
LED2: MSP430.9 (P6.1_UCA3RXD_UCA3SOMI), R5.P$1
LED3: MSP430.10 (P6.2_UCA3CLK), R6.P$1
LED4: MSP430.11 (P6.3_UCA3STE), R7.P$1
unnamed: LED1.ANODE, R4.P$2
unnamed: LED2.ANODE, R5.P$2
unnamed: LED3.ANODE, R6.P$2
unnamed: LED4.ANODE, R7.P$2
P4.1: COMMS.P$8 (PIN8), MSP430.32 (P4.1_A9)
P4.2: COMMS.P$9 (PIN9), MSP430.33 (P4.2_A10)
P4.3: COMMS.P$10 (PIN10), MSP430.34 (P4.3_A11)
PAD: TEMP_SENSOR.7 (PAD)
RST: C13.P$1, JTAG.P$3 (PIN3), MSP430.38 (RST_NMI_SBWTDIO_N), R3.P$2, T4.P$1
SCL: MSP430.14 (P7.1_UCB2SOMI_UCB2SCL), PWR.P$5 (PIN5), R1.P$2, T1.P$1, TEMP_SENSOR.6 (SCL)
SDA: MSP430.13 (P7.0_UCB2SIMO_UCB2SDA), PWR.P$6 (PIN6), R2.P$2, T2.P$1, TEMP_SENSOR.1 (SDA)
TST: JTAG.P$2 (PIN2), MSP430.37 (TEST_SBWTCK), T3.P$1
UCA0CLK: COMMS.P$3 (PIN3), MSP430.18 (P1.5_TB0.2_UCA0CLK_A5_C5)
UCA0SIMO: COMMS.P$1 (PIN1), MSP430.41 (P2.0_TB0.6_UCA0TXD_UCA0SIMO_TB0CLK_ACLK)
UCA0SOMI: COMMS.P$2 (PIN2), MSP430.42 (P2.1_TB0.0_UCA0RXD_UCA0SOMI)
UCA0STE: COMMS.P$4 (PIN4), MSP430.17 (P1.4_TB0.1_UCA0STE_A4_C4)
UCA2CLK: MSP430.67 (P5.6_UCA2CLK_TA4.0_SMCLK), SENSOR.P$5 (PIN5)
UCA2SIMO: MSP430.65 (P5.4_UCA2TXD_UCA2SIMO_TB0OUTH), SENSOR.P$3 (PIN3)
UCA2SOMI: MSP430.66 (P5.5_UCA2RXD_UCA2SOMI_ACLK), SENSOR.P$4 (PIN4)
UCA2STE: MSP430.68 (P5.7_UCA2STE_TA4.1_MCLK), SENSOR.P$6 (PIN6)
UCB1CLK: COMMS.P$5 (PIN5), MSP430.55 (P5.2_UCB1CLK_TA4CLK)
UCB1SIMO: COMMS.P$7 (PIN7), MSP430.53 (P5.0_UCB1SIMO_UCB1SDA)
UCB1SOMI: COMMS.P$6 (PIN6), MSP430.54 (P5.1_UCB1SOMI_UCB1SCL)
UCB3CLK: MSP430.71 (P6.6_UCB3CLK), SENSOR.P$9 (PIN9)
UCB3SIMO_SDA: MSP430.69 (P6.4_UCB3SIMO_UCB3SDA), SENSOR.P$7 (PIN7)
UCB3SOMI_SCL: MSP430.70 (P6.5_UCB3SOMI_UCB3SCL), SENSOR.P$8 (PIN8)
UCB3STE: MSP430.72 (P6.7_UCB3STE), SENSOR.P$10 (PIN10)
V50: C15.P$1, D2.CATHODE, PWR.P$3 (PIN3), PWR_OUT.P$3 (PIN3)
VDD: C0.P$1, C1.P$2, C2.P$2, C3.P$2, C4.P$2, C5.P$2, C6.P$2, C7.P$2, C8.P$2, C9.P$2, C10.P$2, C11.P$2, C12.P$2, C14.P$1, D1.CATHODE, JTAG.P$1 (PIN1), MSP430.20 (DVCC2), MSP430.40 (DVCC3), MSP430.61 (DVCC1), MSP430.80 (AVCC1), PWR.P$2 (PIN2), PWR_OUT.P$2 (PIN2), R1.P$1, R2.P$1, R3.P$1, T5.P$1, TEMP_SENSOR.5 (VDD)

Notes on the sheet:
Test Points (1-pin Headers)
Pins 17-18
Pins 53-55
Pins 41-42
Pins 32-34
Input PWR from COMMS BRD
Temperature Sensor
JTAG Header
Debug LEDs
Output PWR for Sensor
I/O Header for Sensor
Bypass/Bulk Caps
I/O Header for Comms
Pins 63-64
Pins 65-68
Pins 69-72
CHARIoT Processor Board Schematic Ver. A1

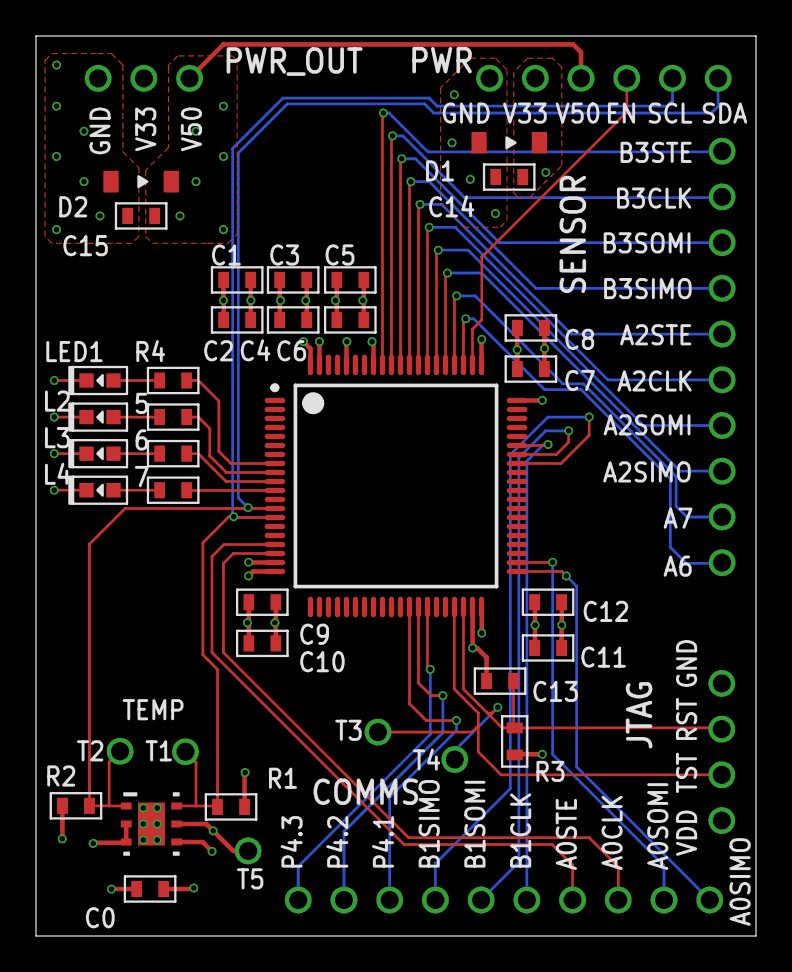
[picture p21: board chariot_sensor.brd from above]

Board: 4 copper layers, 40.0 x 50.0 mm, 41 parts (0 on the bottom side), 36 nets.
