jenniferhellar/CHARIoT/Boards/Prototype #3 (PCB Ver. A2)/CHARIoT_Sensor_A2/sensor_a2.brd

## EAGLE design Boards/Prototype #3 (PCB Ver. A2)/CHARIoT_Sensor_A2/sensor_a2.brd (2020-01-18)

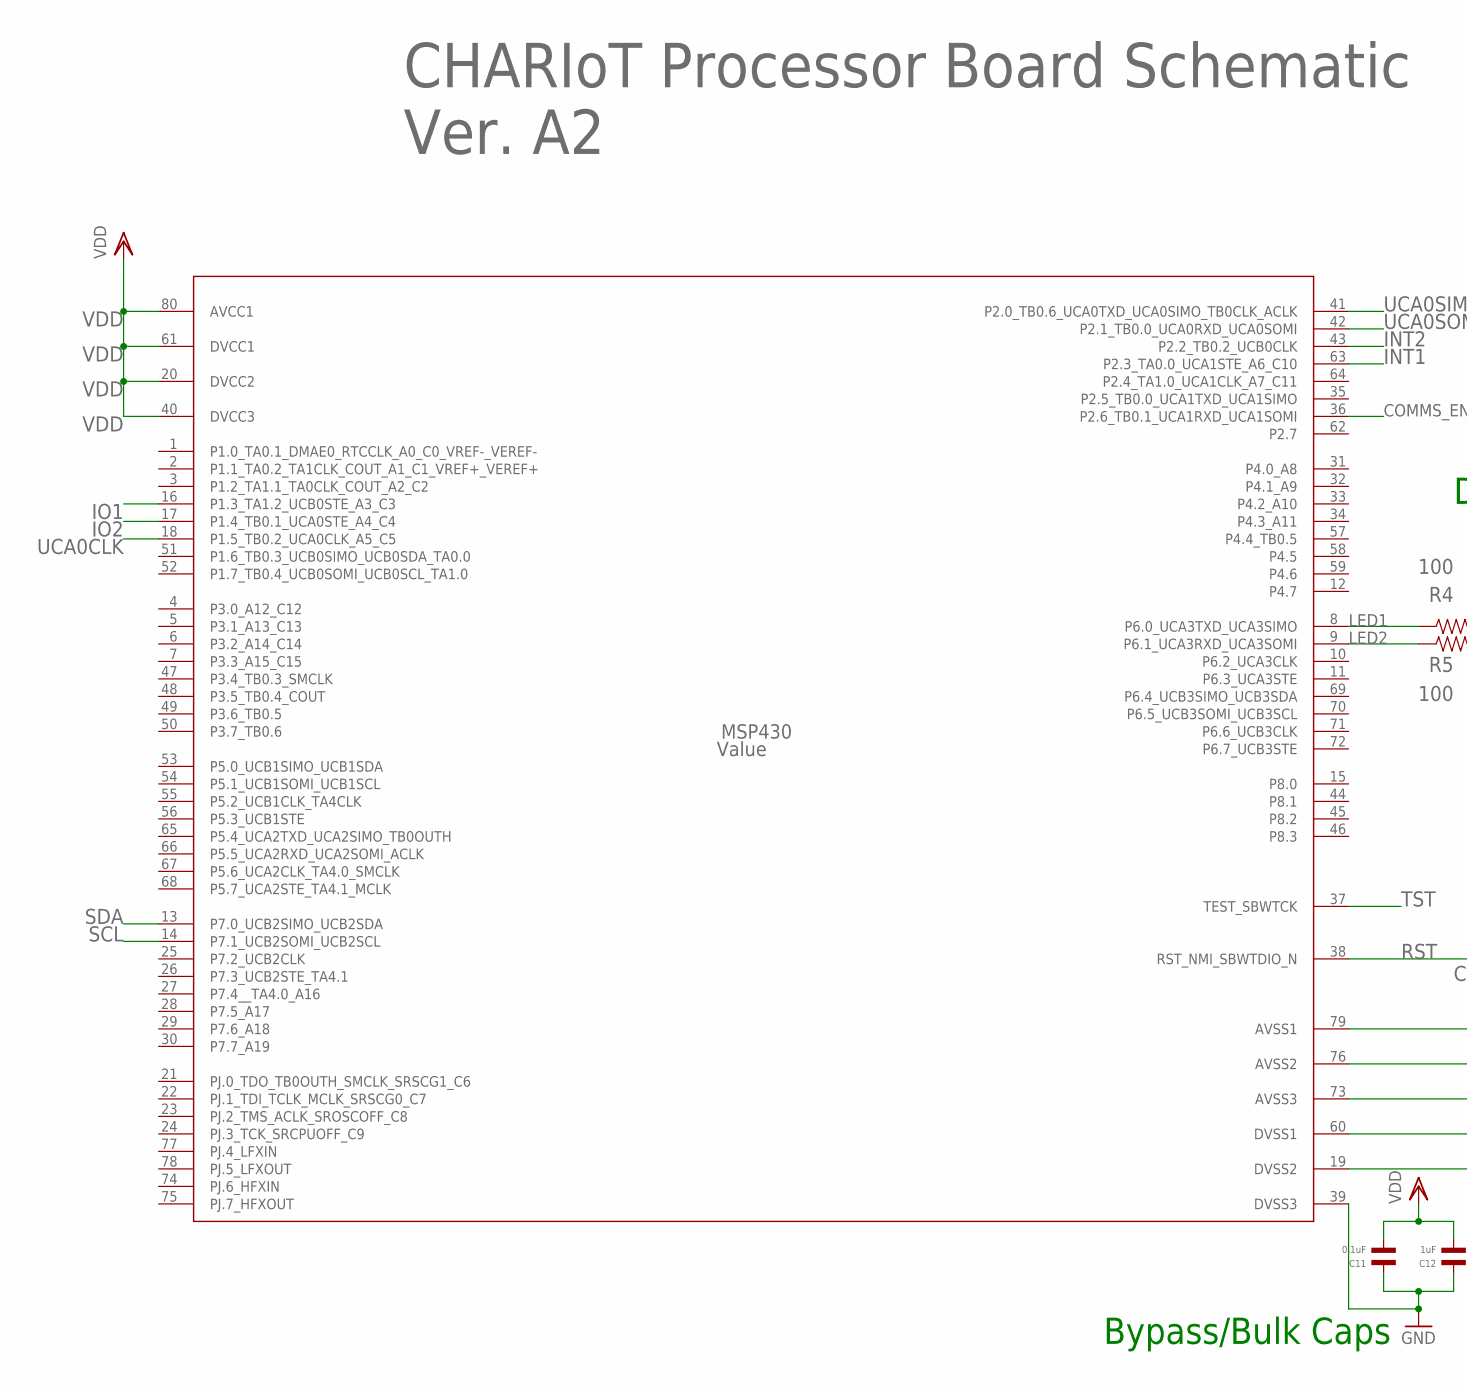
[picture p22: schematic sensor_a2.sch, part in row 1, column 1]

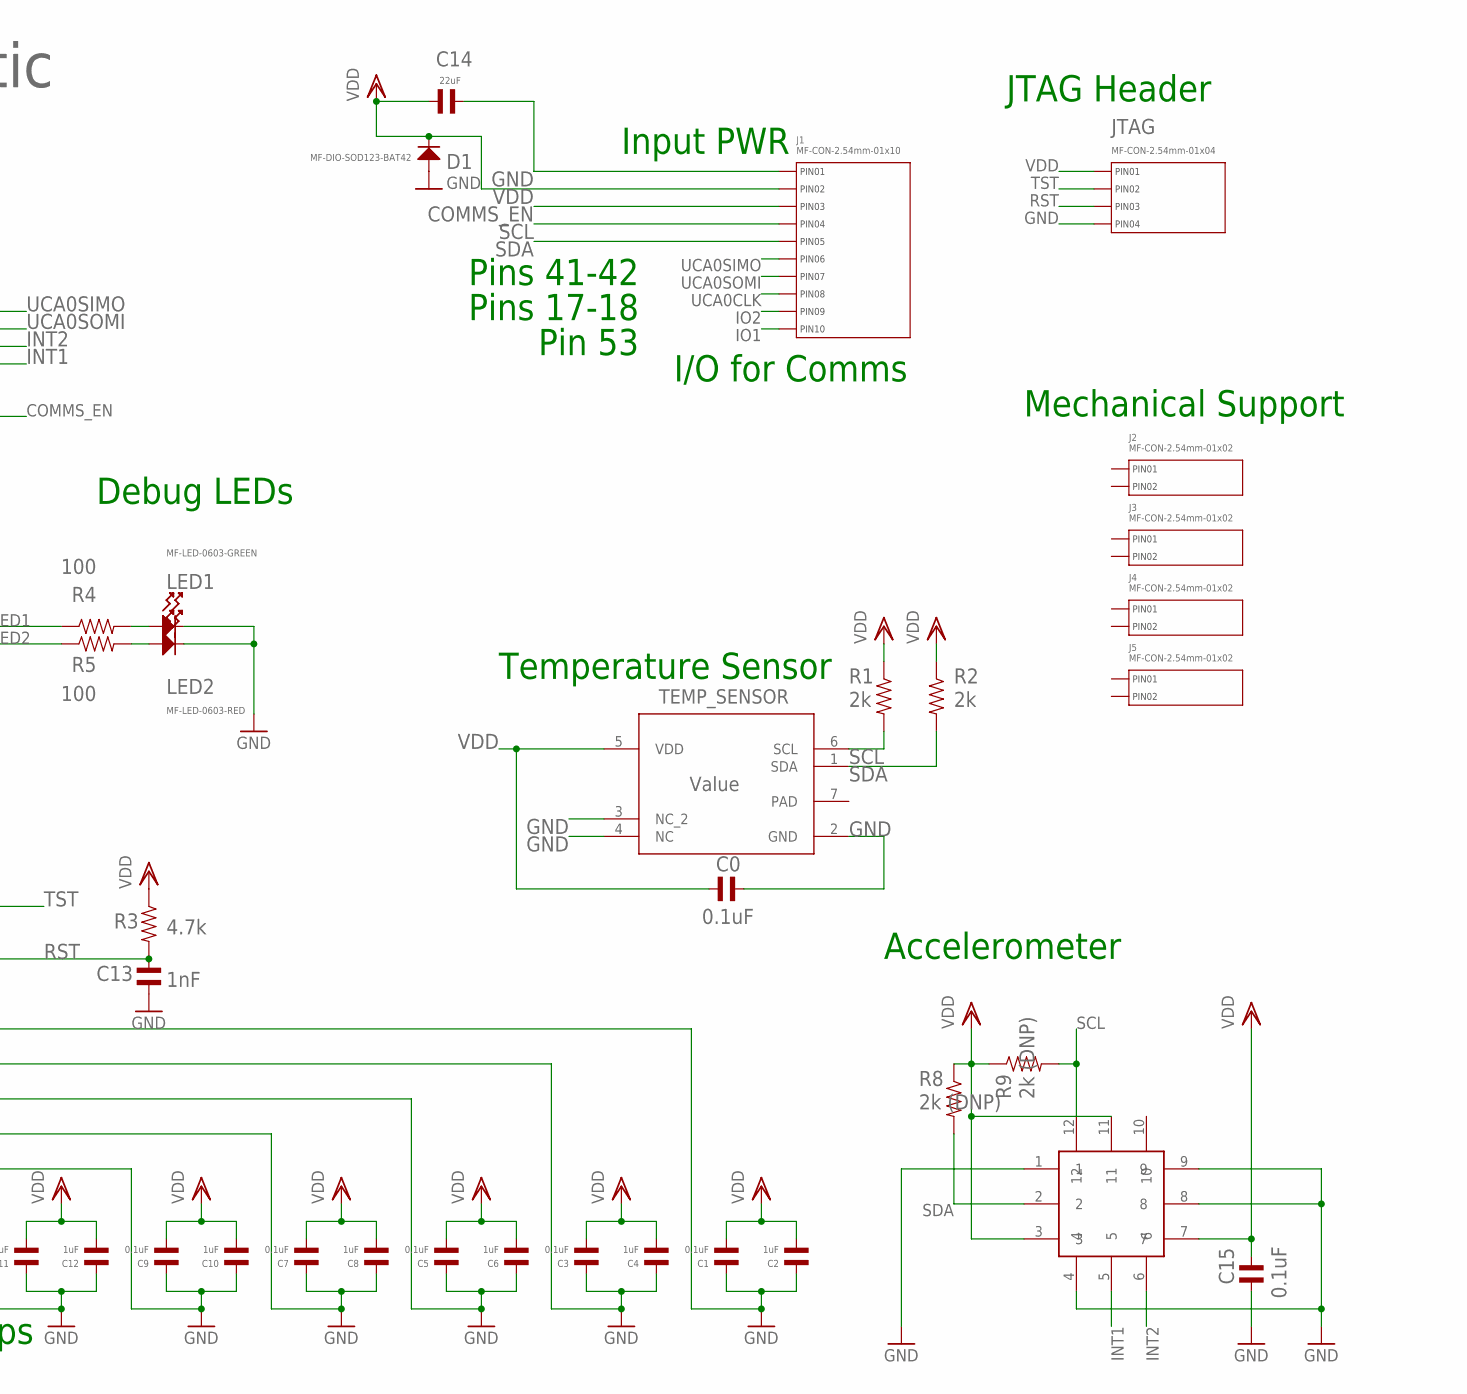
[picture p23: schematic sensor_a2.sch, part in row 1, column 2]

Parts:
ACCEL: BMA253; LGA-12
C0, C1, C3, C5, C7, C9, C11, C15: 0.1uF; C0603
C2, C4, C6, C8, C10, C12: 1uF; C0603
C13: 1nF; C0603
C14: 22uF; C0603
D1: MF-DIO-SOD123-BAT42; SOD-123
J1: MF-CON-2.54mm-01x10; PTH_2.54MM_01X10
J2, J3, J4, J5: MF-CON-2.54mm-01x02; PTH_2.54MM_01X02
JTAG: MF-CON-2.54mm-01x04; PTH_2.54MM_01X04
LED1: MF-LED-0603-GREEN; LED0603
LED2: MF-LED-0603-RED; LED0603
MSP430: Value; PN0080A_N
R1, R2: 2k; R0603
R3: 4.7k; R0603
R4, R5: 100; R0603
R8, R9: 2k (DNP); R0603
TEMP_SENSOR: Value; DMB0006A

Connections:
COMMS_EN: J1.P$3 (PIN3), MSP430.36 (P2.6_TB0.1_UCA1RXD_UCA1SOMI)
GND: ACCEL.1, ACCEL.4, ACCEL.8, ACCEL.9, C0.P$2, C1.P$1, C2.P$1, C3.P$1, C4.P$1, C5.P$1, C6.P$1, C7.P$1, C8.P$1, C9.P$1, C10.P$1, C11.P$1, C12.P$1, C13.P$2, C14.P$2, C15.P$1, D1.ANODE, J1.P$1 (PIN1), JTAG.P$4 (PIN4), LED1.CATHODE, LED2.CATHODE, MSP430.19 (DVSS2), MSP430.39 (DVSS3), MSP430.60 (DVSS1), MSP430.73 (AVSS3), MSP430.76 (AVSS2), MSP430.79 (AVSS1), TEMP_SENSOR.2 (GND), TEMP_SENSOR.3 (NC_2), TEMP_SENSOR.4 (NC)
INT1: ACCEL.5, MSP430.63 (P2.3_TA0.0_UCA1STE_A6_C10)
INT2: ACCEL.6, MSP430.43 (P2.2_TB0.2_UCB0CLK)
IO1: J1.P$10 (PIN10), MSP430.16 (P1.3_TA1.2_UCB0STE_A3_C3)
IO2: J1.P$9 (PIN9), MSP430.17 (P1.4_TB0.1_UCA0STE_A4_C4)
LED1: MSP430.8 (P6.0_UCA3TXD_UCA3SIMO), R4.P$1
LED2: MSP430.9 (P6.1_UCA3RXD_UCA3SOMI), R5.P$1
unnamed: LED1.ANODE, R4.P$2
unnamed: LED2.ANODE, R5.P$2
PAD: TEMP_SENSOR.7 (PAD)
RST: C13.P$1, JTAG.P$3 (PIN3), MSP430.38 (RST_NMI_SBWTDIO_N), R3.P$2
SCL: ACCEL.12, J1.P$4 (PIN4), MSP430.14 (P7.1_UCB2SOMI_UCB2SCL), R1.P$2, R9.P$2, TEMP_SENSOR.6 (SCL)
SDA: ACCEL.2, J1.P$5 (PIN5), MSP430.13 (P7.0_UCB2SIMO_UCB2SDA), R2.P$2, R8.P$2, TEMP_SENSOR.1 (SDA)
TST: JTAG.P$2 (PIN2), MSP430.37 (TEST_SBWTCK)
UCA0CLK: J1.P$8 (PIN8), MSP430.18 (P1.5_TB0.2_UCA0CLK_A5_C5)
UCA0SIMO: J1.P$6 (PIN6), MSP430.41 (P2.0_TB0.6_UCA0TXD_UCA0SIMO_TB0CLK_ACLK)
UCA0SOMI: J1.P$7 (PIN7), MSP430.42 (P2.1_TB0.0_UCA0RXD_UCA0SOMI)
VDD: ACCEL.3, ACCEL.7, ACCEL.11, C0.P$1, C1.P$2, C2.P$2, C3.P$2, C4.P$2, C5.P$2, C6.P$2, C7.P$2, C8.P$2, C9.P$2, C10.P$2, C11.P$2, C12.P$2, C14.P$1, C15.P$2, D1.CATHODE, J1.P$2 (PIN2), JTAG.P$1 (PIN1), MSP430.20 (DVCC2), MSP430.40 (DVCC3), MSP430.61 (DVCC1), MSP430.80 (AVCC1), R1.P$1, R2.P$1, R3.P$1, R8.P$1, R9.P$1, TEMP_SENSOR.5 (VDD)

Notes on the sheet:
Pins 17-18
Pin 53
Pins 41-42
Input PWR
Temperature Sensor
JTAG Header
Debug LEDs
Bypass/Bulk Caps
I/O for Comms
CHARIoT Processor Board Schematic Ver. A2
Accelerometer
Mechanical Support

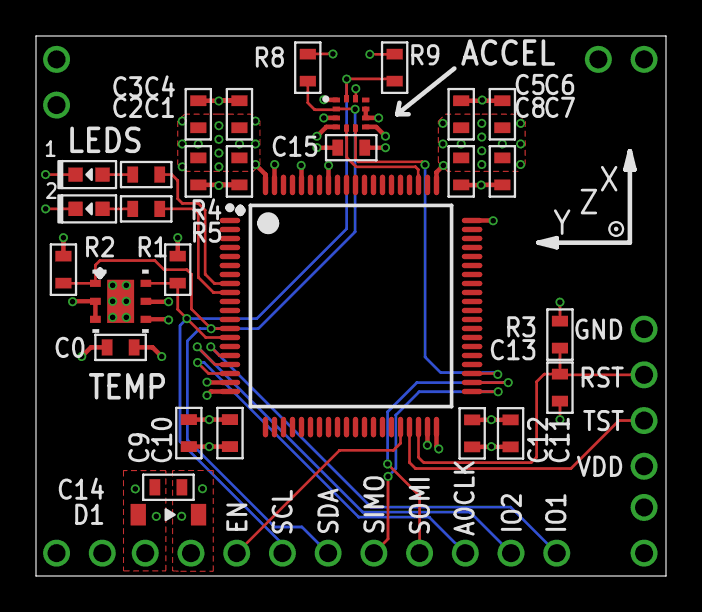
[picture p24: board sensor_a2.brd from above]

Board: 4 copper layers, 35.0 x 30.0 mm, 36 parts (0 on the bottom side), 18 nets.

Other parts of the board:
U$1: XYZ-LABEL
