jenniferhellar/CHARIoT/Code/CCSWorkspace/A0 - Discrete/p7_i2c.h

#ifndef P7_I2C_H_
#define P7_I2C_H_

/*
 * Code to initialize the port 7 I2C module.
 */
void p7_i2c_setup();

/*
 * This function writes a series of bytes to the specified address over I2C. If
 * the peripheral device does not ACK a byte, the transmission is aborted and
 * a 0 is returned.
 *
 * Inputs:
 *     addr - A 7-bit peripheral address.
 *     tx_data - A byte array of data to be transmitted.
 *     len - The number of bytes from data to be transmitted.
 *     no_stp - True if no stop condition should be sent.
 *
 * Returns:
 *     1 if all of the data was ACKed by the peripheral, a 0 otherwise.
 */
uint8_t p7_i2c_write(uint8_t addr, uint8_t *tx_data, unsigned int len,
                     unsigned int no_stp);

/*
 * This function reads a series of bytes from the specified address over I2C.
 *
 * Inputs:
 *     addr - A 7-bit peripheral address.
 *     len - The number of bytes of data to receive.
 *
 * Returns:
 *     A byte array of length data_len received from the peripheral. The memory
 *     for this data is allocated using malloc(len).
 */
uint8_t *p7_i2c_read(uint8_t addr, unsigned int len);

#endif /* P7_I2C_H_ */
