jenniferhellar/CHARIoT/Code/TICommsWorkspace/ble5_simple_central_cc26x2r1lp_app/Application/chariot.h

#ifndef APPLICATION_CHARIOT_H_
#define APPLICATION_CHARIOT_H_

/*
 * Bluefruit App - Peripheral Mode, nRF UART Service (UUID in reverse byte order (little endian))
 */
const uint8_t CHARIOT_UART_SVC_UUID[] = {0x9E, 0xCA, 0xDC, 0x24, 0x0E, 0xE5, 0xA9, 0xE0, 0x93, 0xF3, 0xA3, 0xB5, 0x01, 0x00, 0x40, 0x6E};
#define CHARIOT_UART_SVC_UUID_LEN 16
// Characteristic UUIDs in reverse byte order (little endian) as well
const uint8_t CHARIOT_UART_TXD_UUID[] = {0x9E, 0xCA, 0xDC, 0x24, 0x0E, 0xE5, 0xA9, 0xE0, 0x93, 0xF3, 0xA3, 0xB5, 0x02, 0x00, 0x40, 0x6E};
const uint8_t CHARIOT_UART_RXD_UUID[] = {0x9E, 0xCA, 0xDC, 0x24, 0x0E, 0xE5, 0xA9, 0xE0, 0x93, 0xF3, 0xA3, 0xB5, 0x03, 0x00, 0x40, 0x6E};
#define CHARIOT_UART_CHAR_UUID_LEN 16

/*
 * GenericAccess Service (UUID in reverse byte order (little endian))
 */
const uint8_t CHARIOT_GENERIC_SVC_UUID[] = {0xFB, 0x34, 0x9B, 0x5F, 0x80, 0x00, 0x00, 0x80, 0x00, 0x10, 0x00, 0x00, 0x00, 0x18, 0x00, 0x00};
#define CHARIOT_GENERIC_SVC_UUID_LEN 16
// Characteristic UUIDs in reverse byte order (little endian) as well

#endif /* APPLICATION_CHARIOT_H_ */
