jenniferhellar/CHARIoT/(commit log)

2020-01-18 Board designs
    [chariot_comms_a.brd, chariot_comms_a.sch, chariot_comms_a2.brd, chariot_comms_a2.sch, chariot_comms_b.brd, chariot_comms_b.sch, chariot_power.brd, chariot_power.sch]
2020-11-08 Added additional documentation, summary presentation, meeting notes
    [Final BOM.xlsx]
